knightspan/Nashik-Water/docs/screenshots/admin-ingest.png

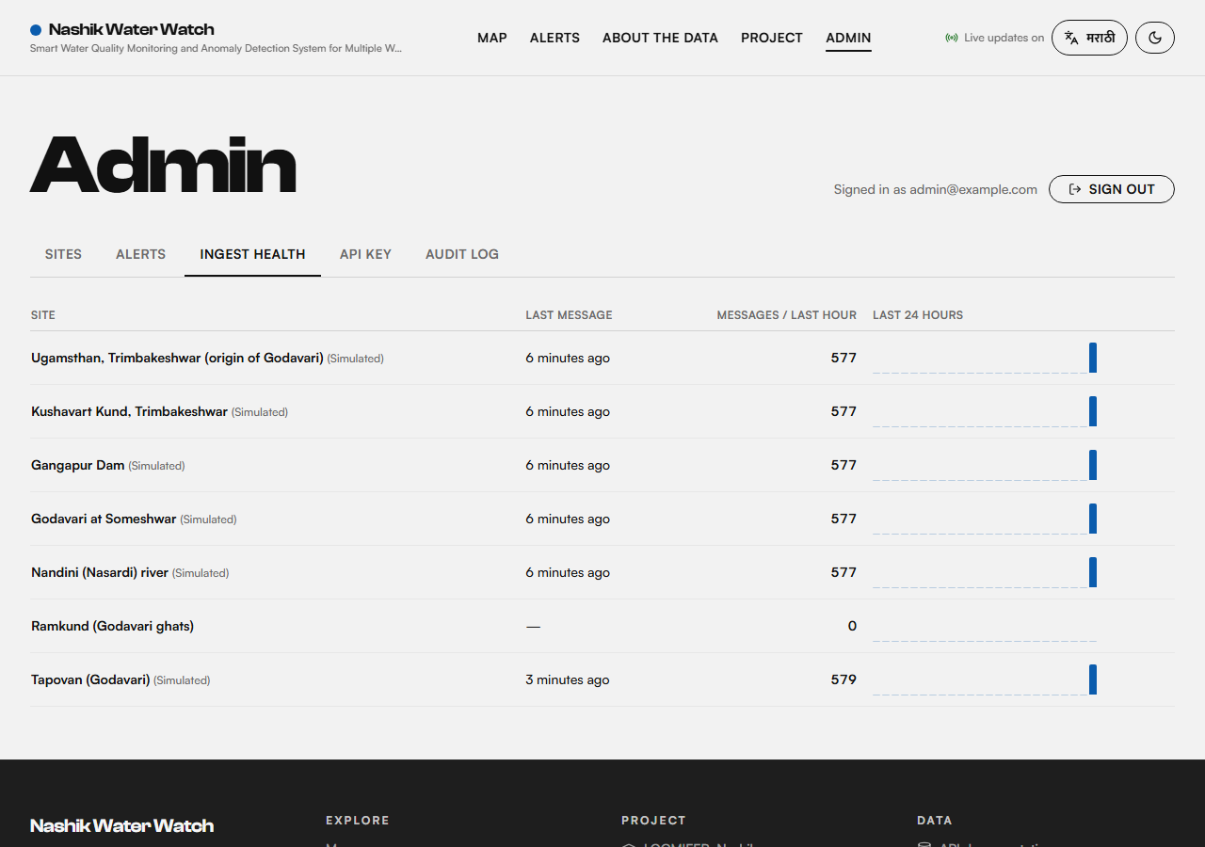
docs/screenshots/admin-ingest.png
