knightspan/Nashik-Water/docs/screenshots/site-phone-mr.png

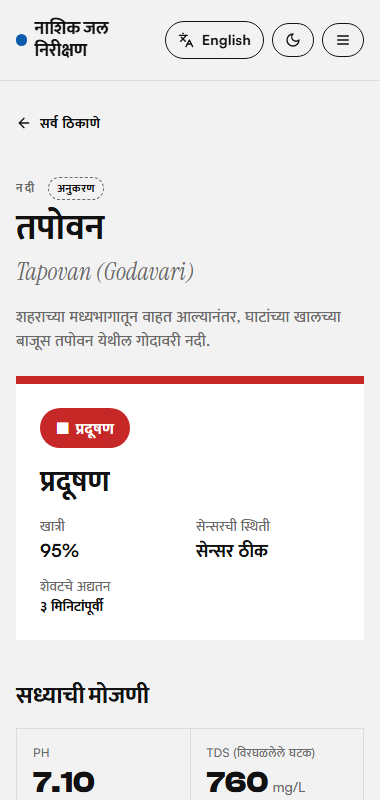
docs/screenshots/site-phone-mr.png
