knightspan/Nashik-Water/WQM_code/diagrams/a4_boxplot.png

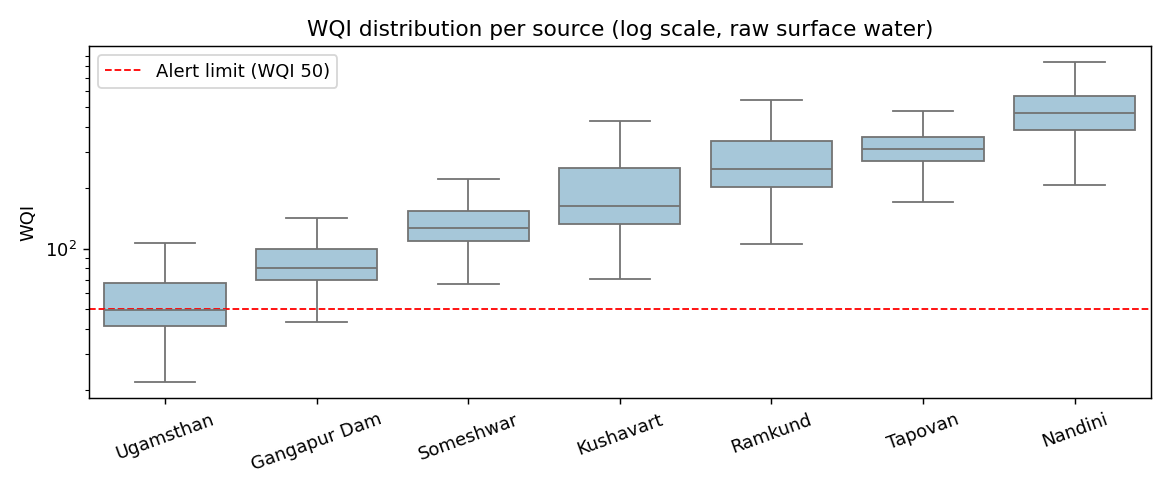
WQM_code/diagrams/a4_boxplot.png
