knightspan/Nashik-Water/WQM_code/diagrams/a4_corr.png

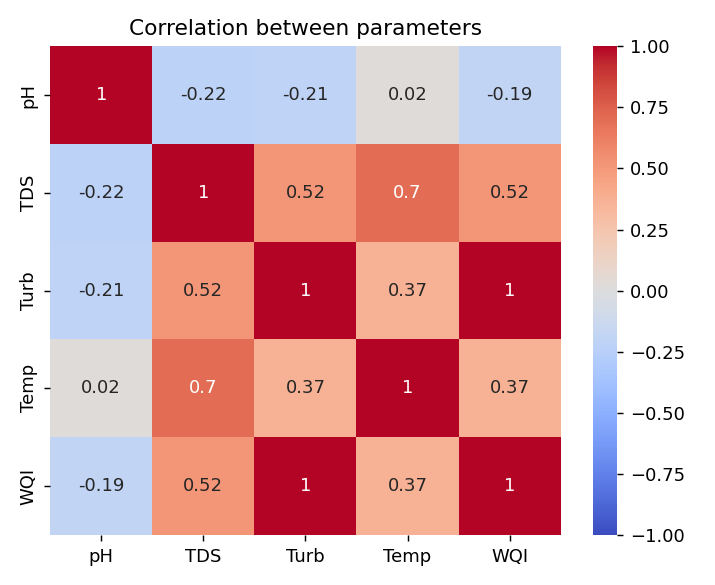
WQM_code/diagrams/a4_corr.png
