knightspan/Nashik-Water/WQM_code/diagrams/a4_diurnal.png

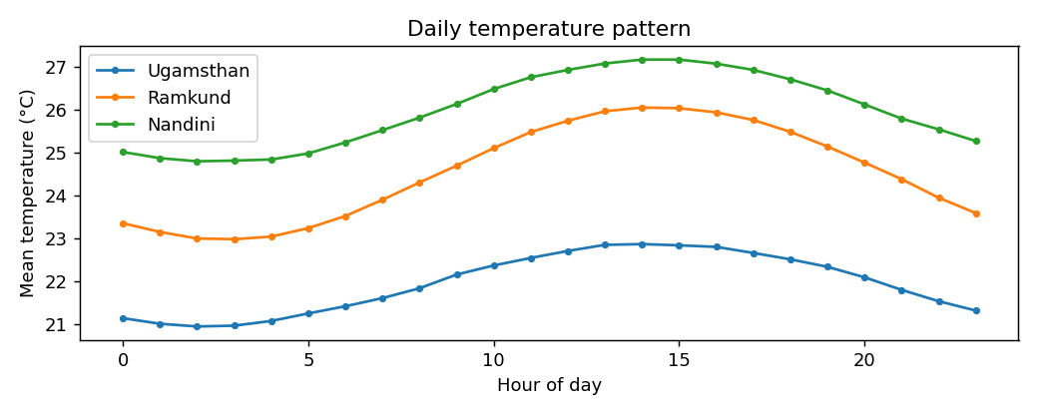
WQM_code/diagrams/a4_diurnal.png
