knightspan/Nashik-Water/WQM_code/diagrams/a4_hampel.png

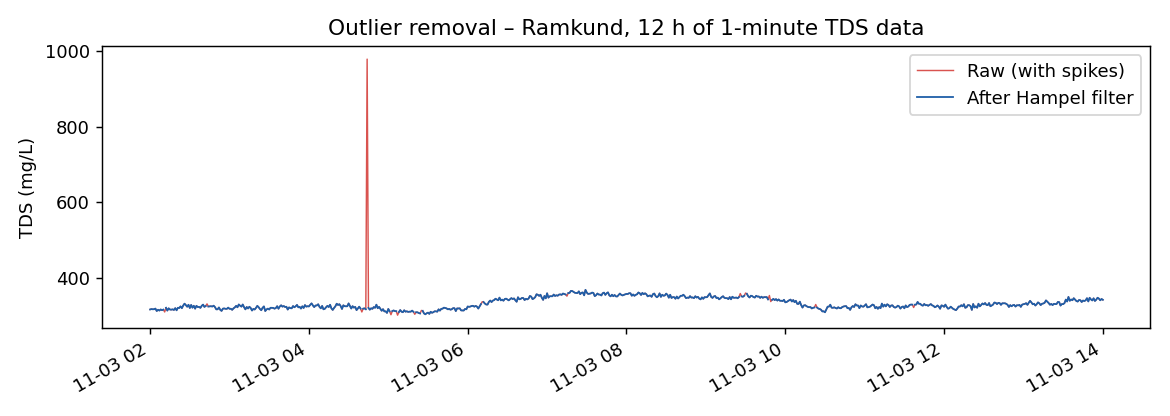
WQM_code/diagrams/a4_hampel.png
