knightspan/Nashik-Water/WQM_code/diagrams/a4_means.png

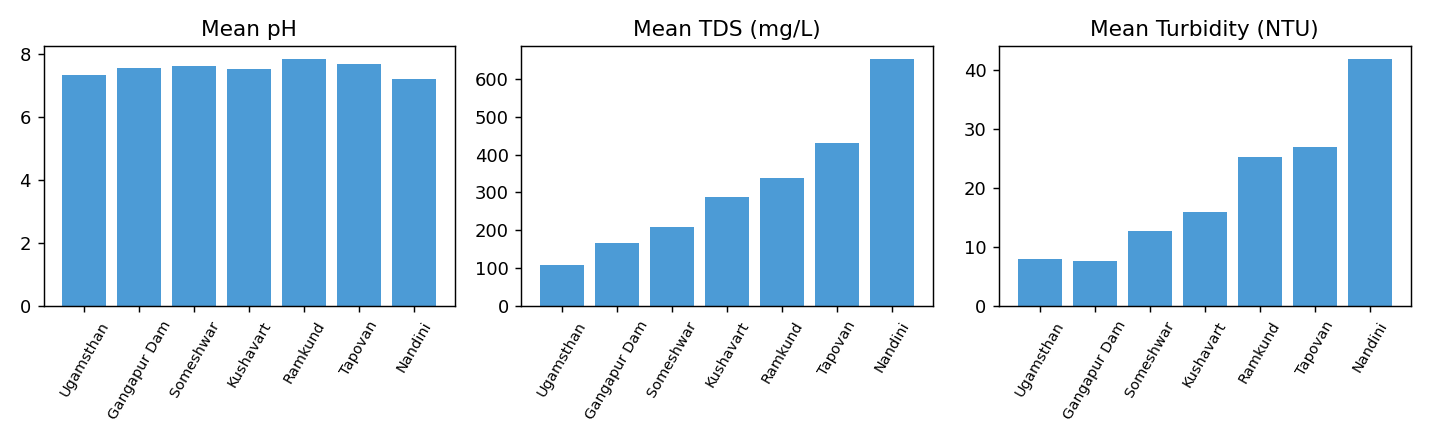
WQM_code/diagrams/a4_means.png
