knightspan/Nashik-Water/WQM_code/diagrams/a4_missing.png

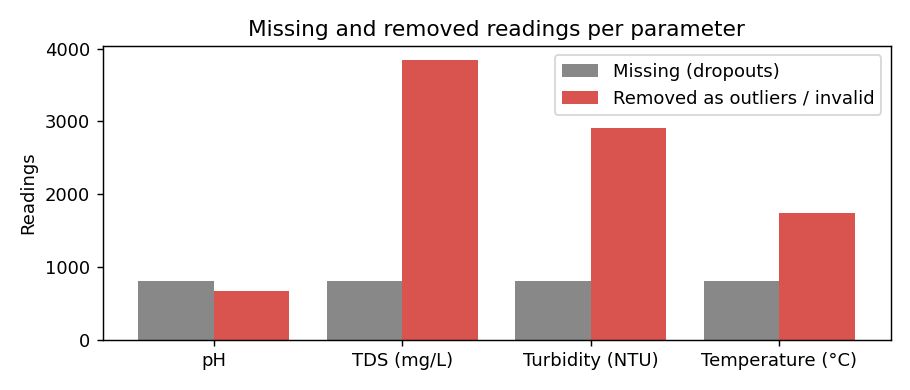
WQM_code/diagrams/a4_missing.png
