knightspan/Nashik-Water/WQM_code/diagrams/a4_timeseries.png

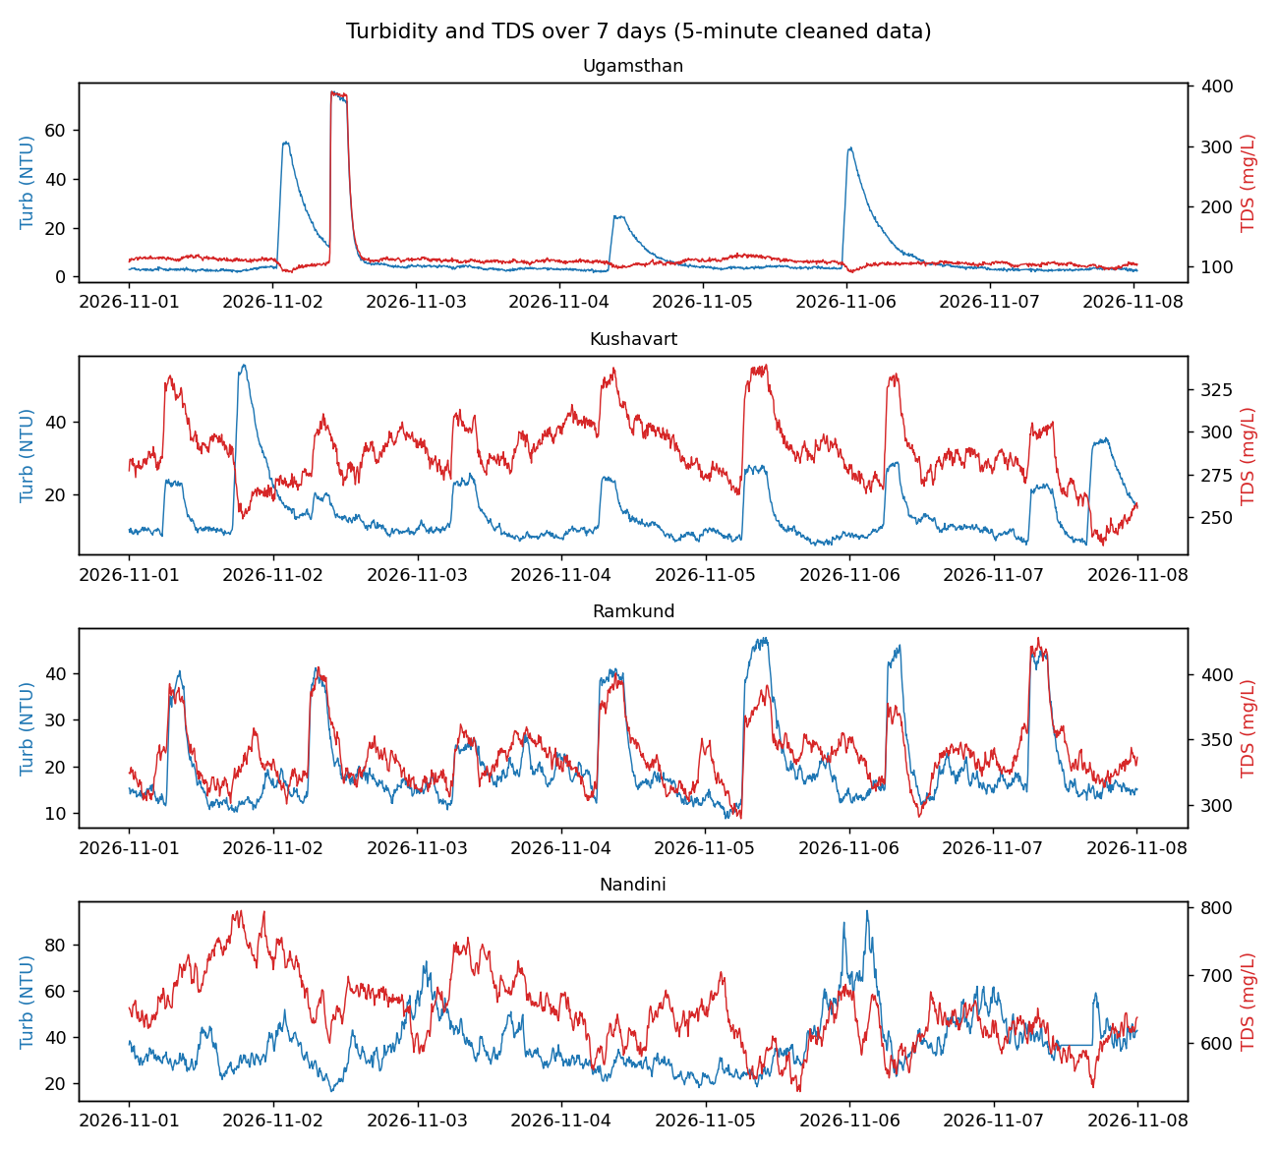
WQM_code/diagrams/a4_timeseries.png
