knightspan/Nashik-Water/WQM_code/diagrams/a5_classes.png

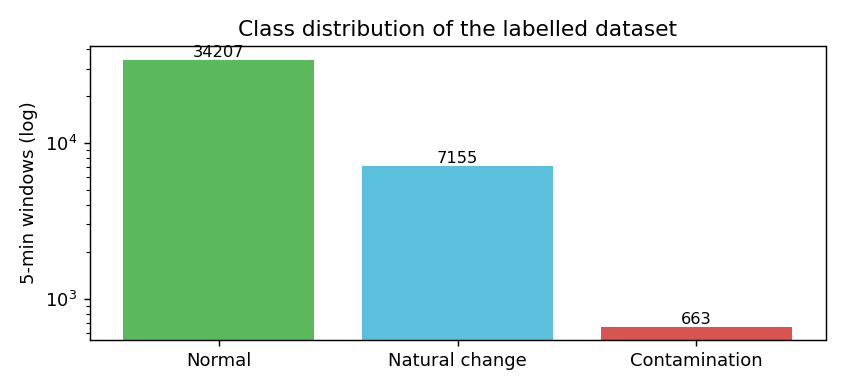
WQM_code/diagrams/a5_classes.png
