knightspan/Nashik-Water/WQM_code/diagrams/a5_cm_decision_tree.png

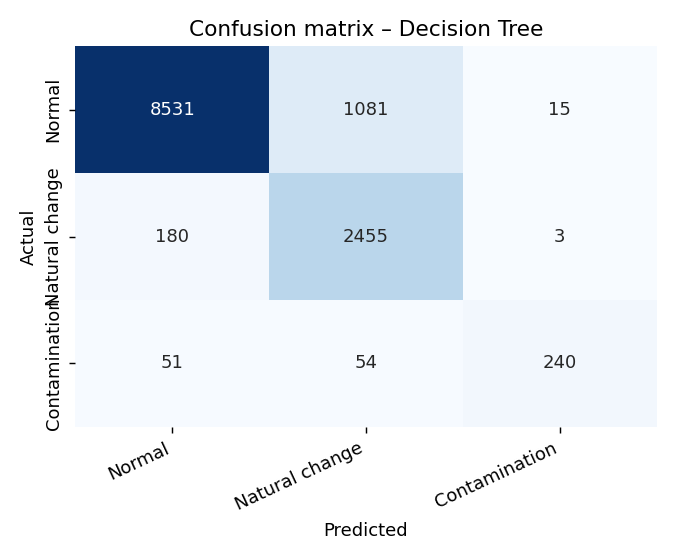
WQM_code/diagrams/a5_cm_decision_tree.png
