knightspan/Nashik-Water/WQM_code/diagrams/a5_comparison.png

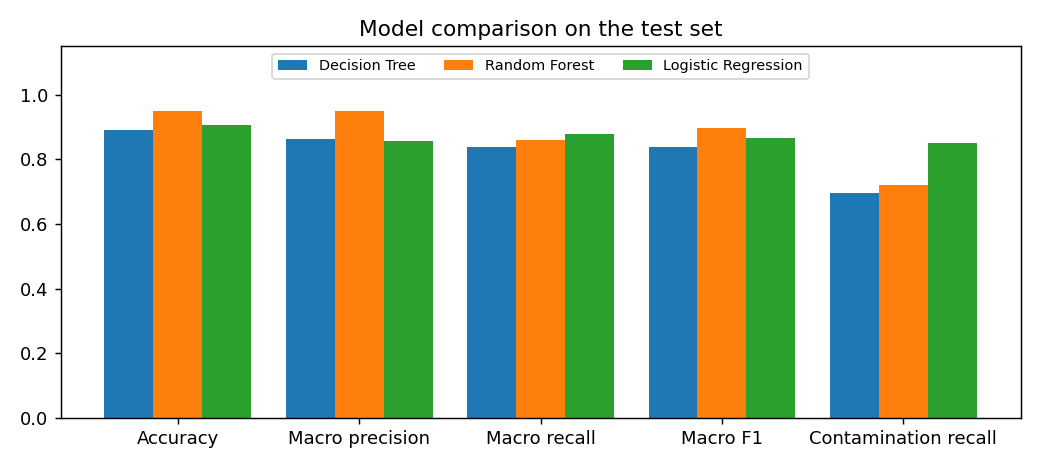
WQM_code/diagrams/a5_comparison.png
