knightspan/Nashik-Water/WQM_code/diagrams/a5_importance.png

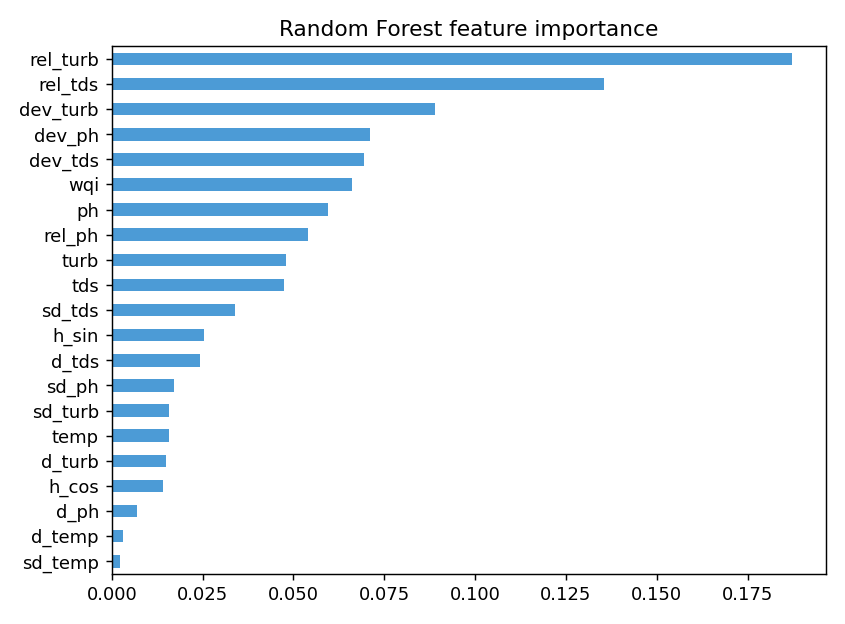
WQM_code/diagrams/a5_importance.png
