knightspan/Nashik-Water/WQM_code/diagrams/a6_confidence.png

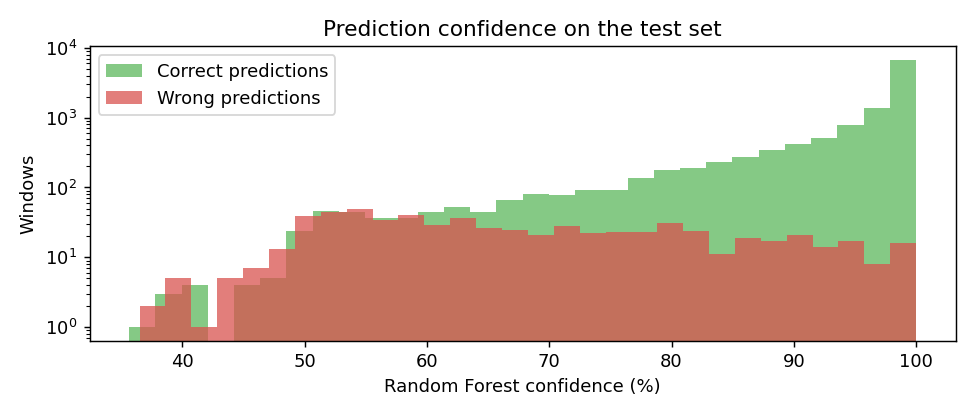
WQM_code/diagrams/a6_confidence.png
