knightspan/Nashik-Water/WQM_code/diagrams/a6_event.png

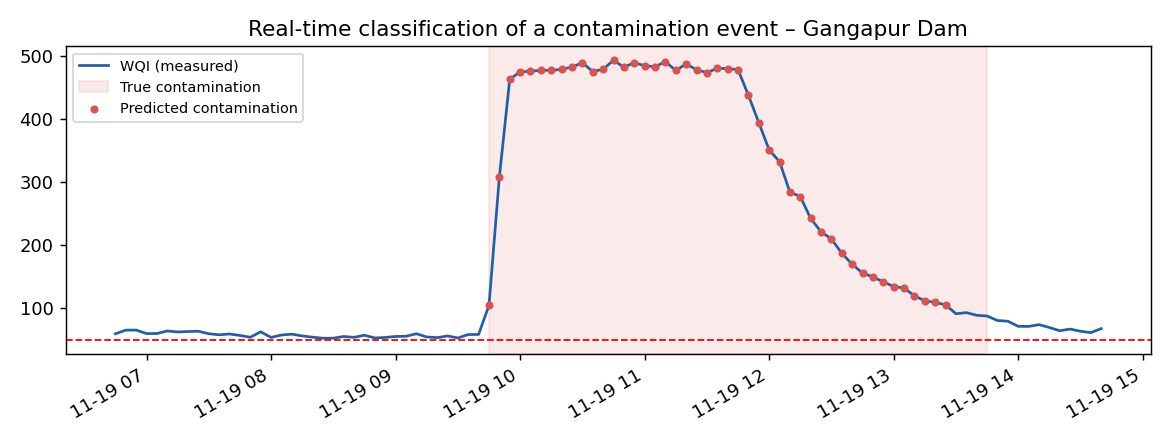
WQM_code/diagrams/a6_event.png
