knightspan/Nashik-Water/WQM_code/diagrams/a6_health_cm.png

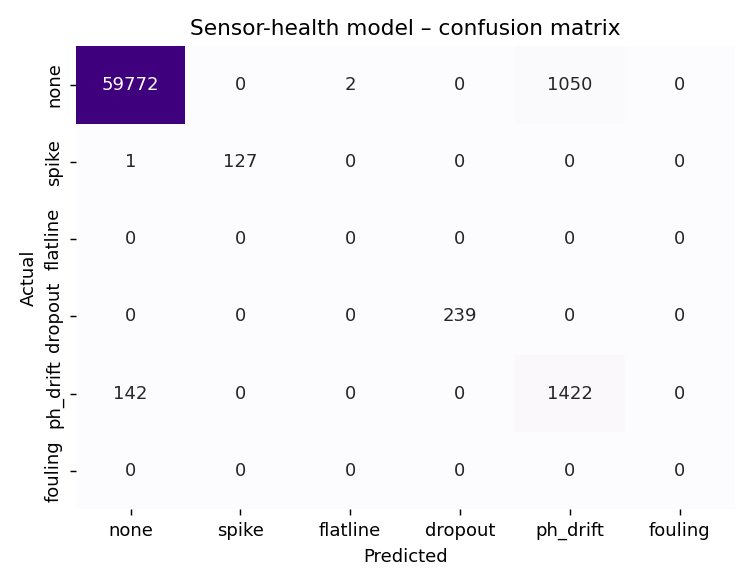
WQM_code/diagrams/a6_health_cm.png
