knightspan/Nashik-Water/WQM_code/diagrams/a7_edge_cm.png

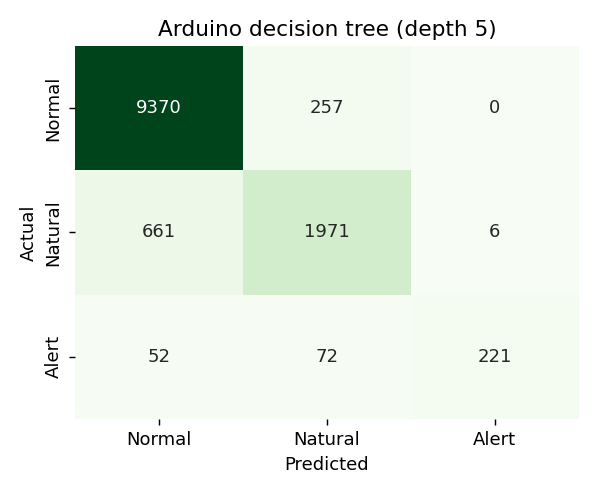
WQM_code/diagrams/a7_edge_cm.png
