knightspan/Nashik-Water/WQM_code/diagrams/alert_flow.png

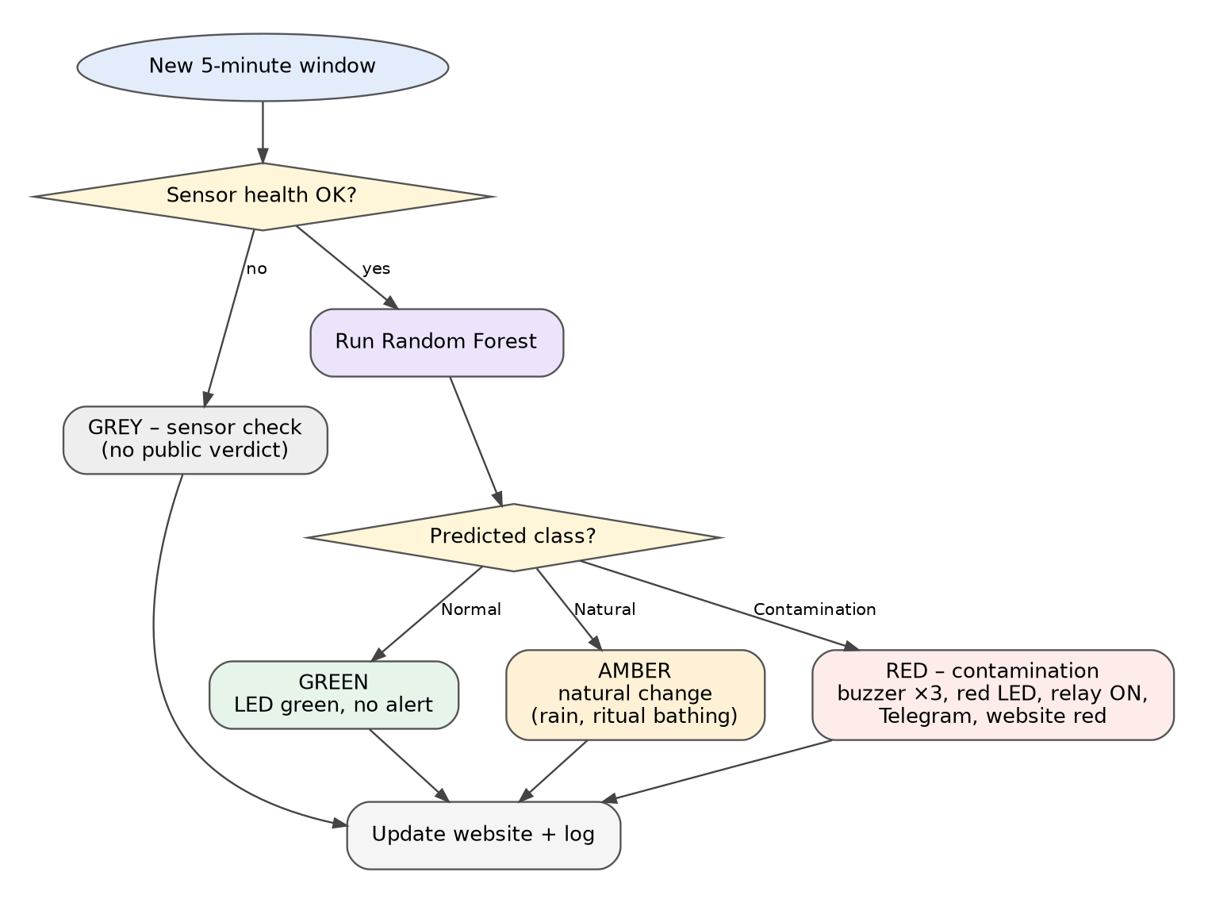
WQM_code/diagrams/alert_flow.png
