knightspan/Nashik-Water/WQM_code/diagrams/arduino_flow.png

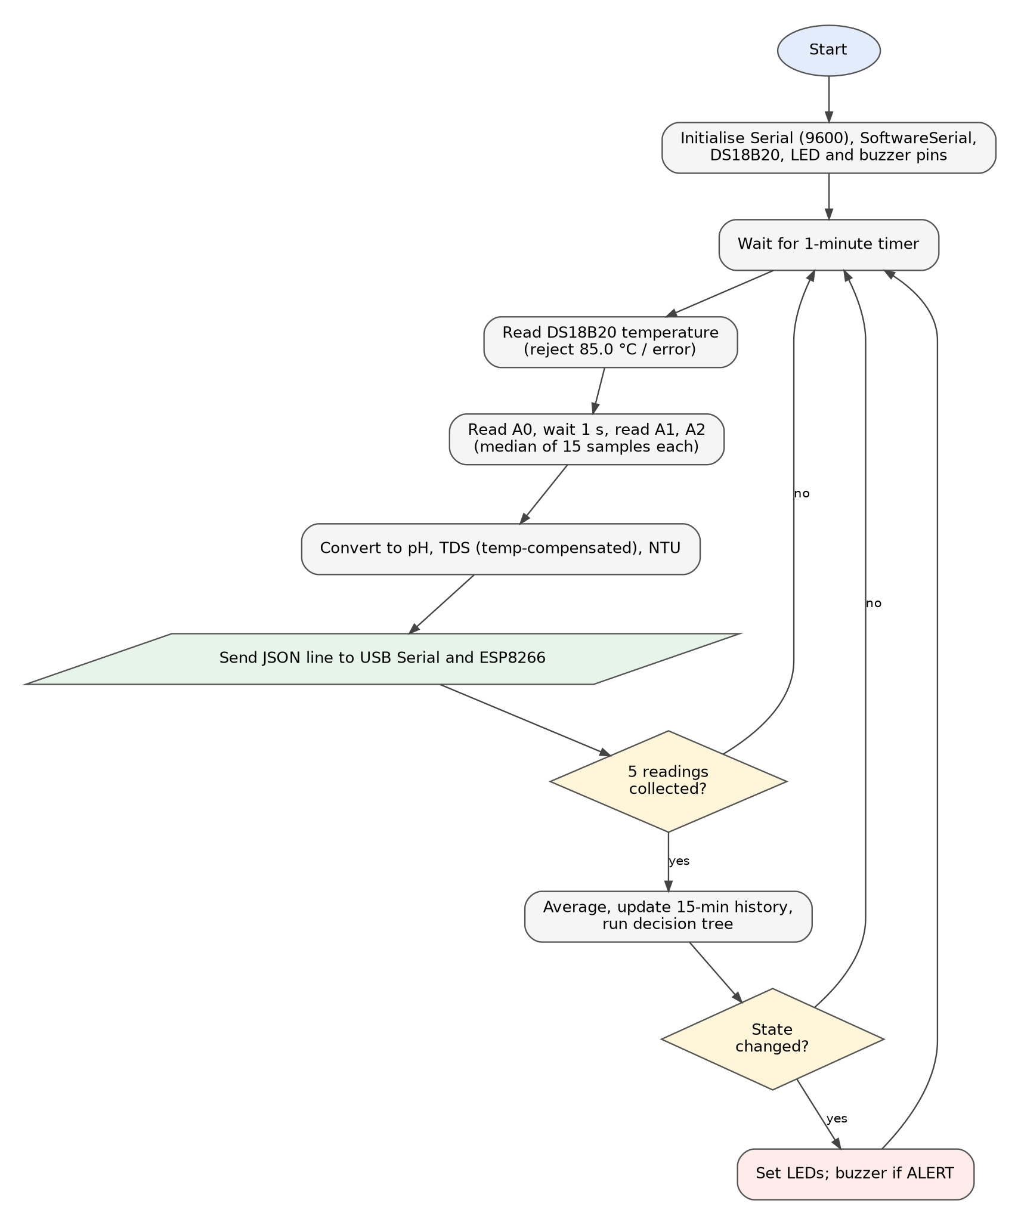
WQM_code/diagrams/arduino_flow.png
