knightspan/Nashik-Water/WQM_code/diagrams/cloud_flow.png

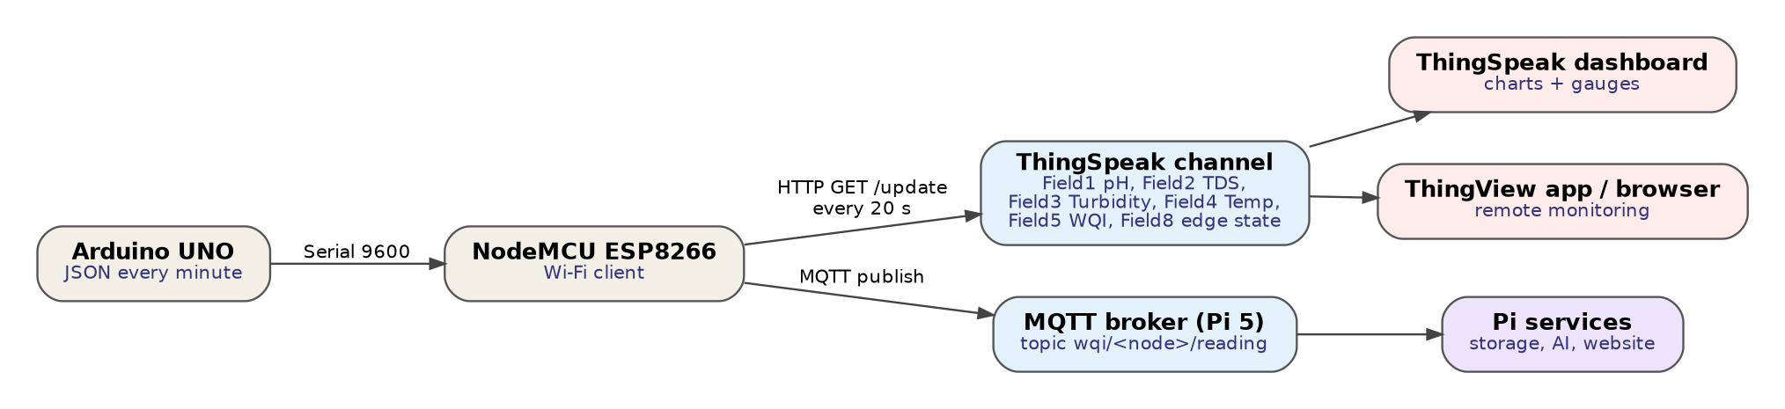
WQM_code/diagrams/cloud_flow.png
