knightspan/Nashik-Water/WQM_code/diagrams/design_thinking.png

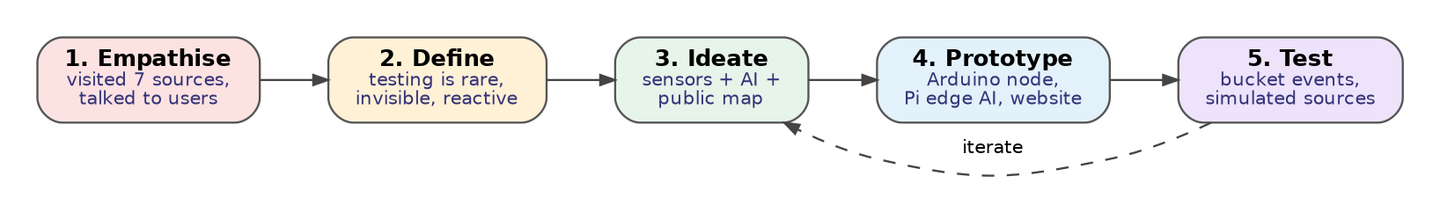
WQM_code/diagrams/design_thinking.png
