knightspan/Nashik-Water/WQM_code/diagrams/edge_cloud.png

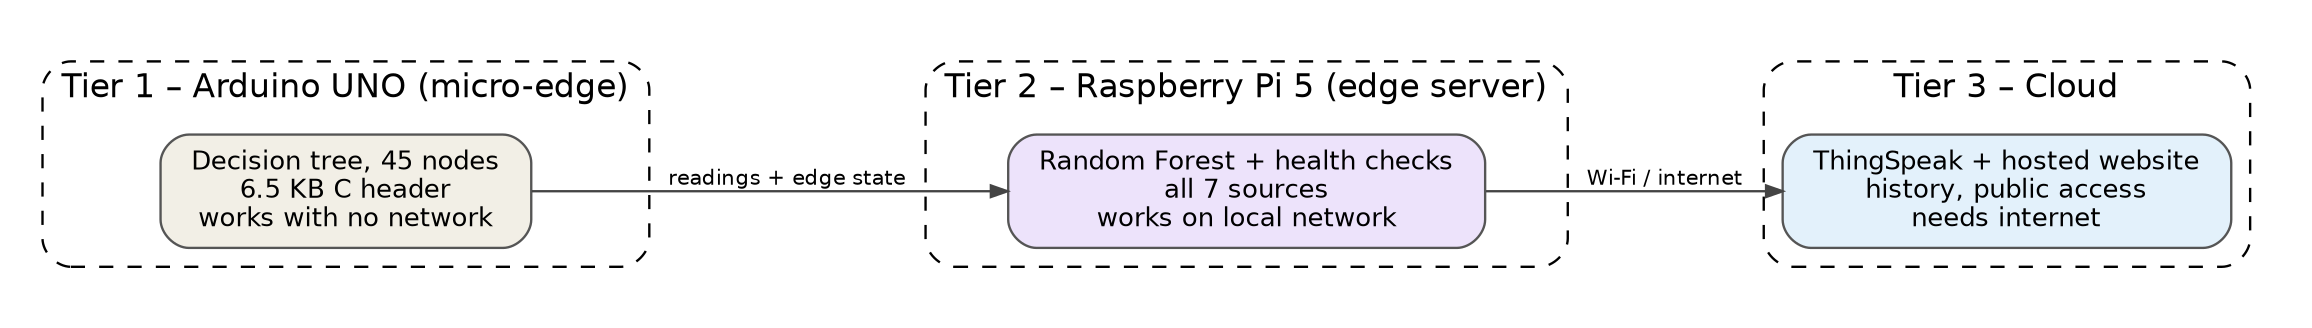
WQM_code/diagrams/edge_cloud.png
