knightspan/Nashik-Water/WQM_code/diagrams/esp_flow.png

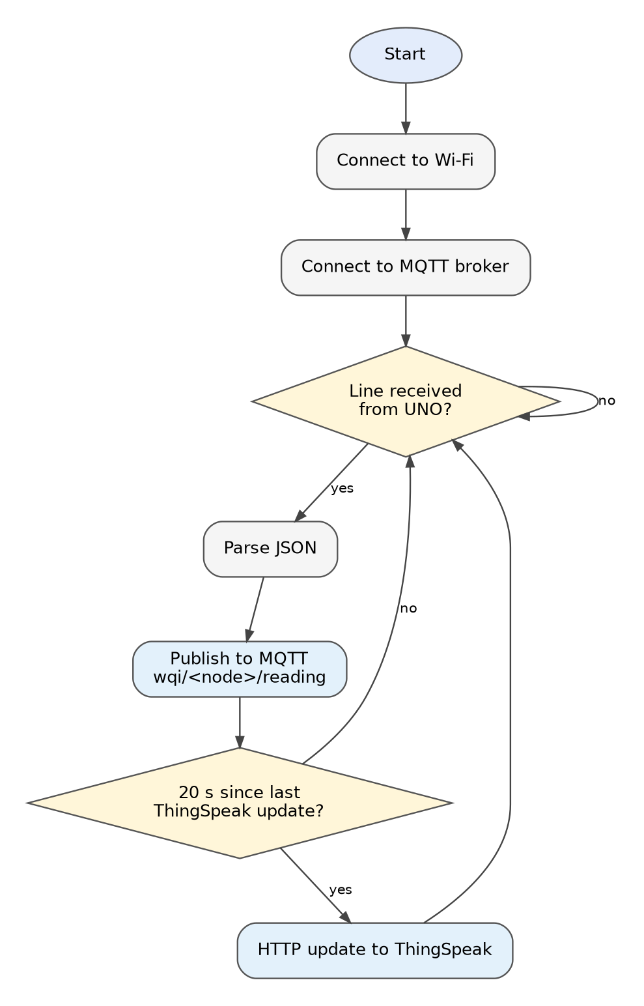
WQM_code/diagrams/esp_flow.png
