knightspan/Nashik-Water/WQM_code/diagrams/gantt.png

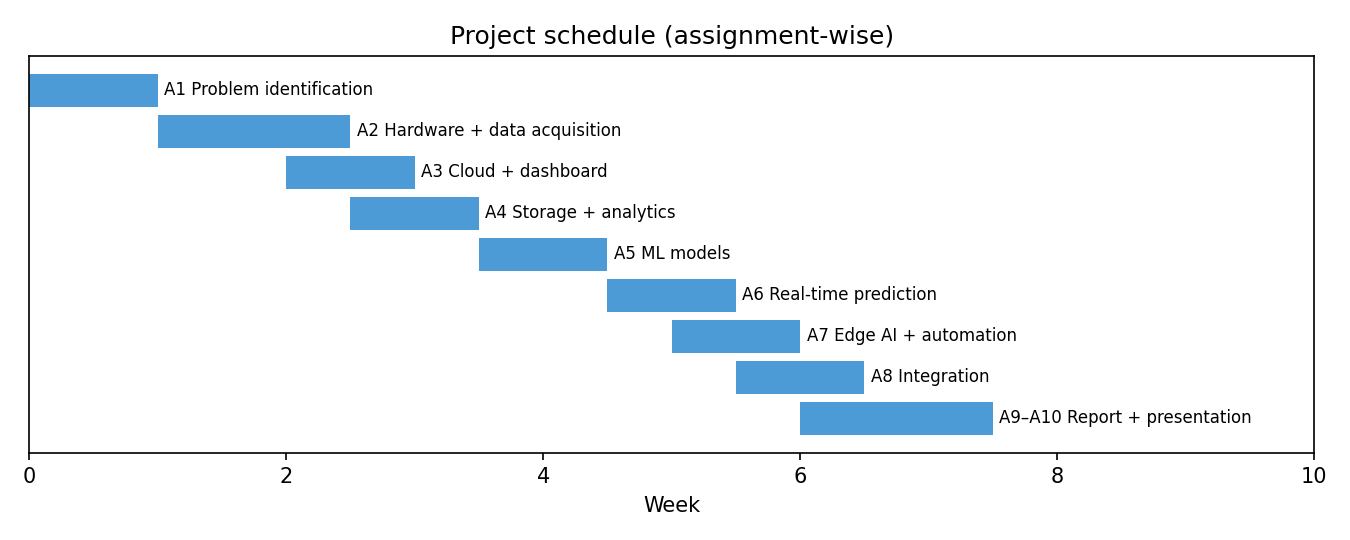
WQM_code/diagrams/gantt.png
