knightspan/Nashik-Water/WQM_code/diagrams/hw_block.png

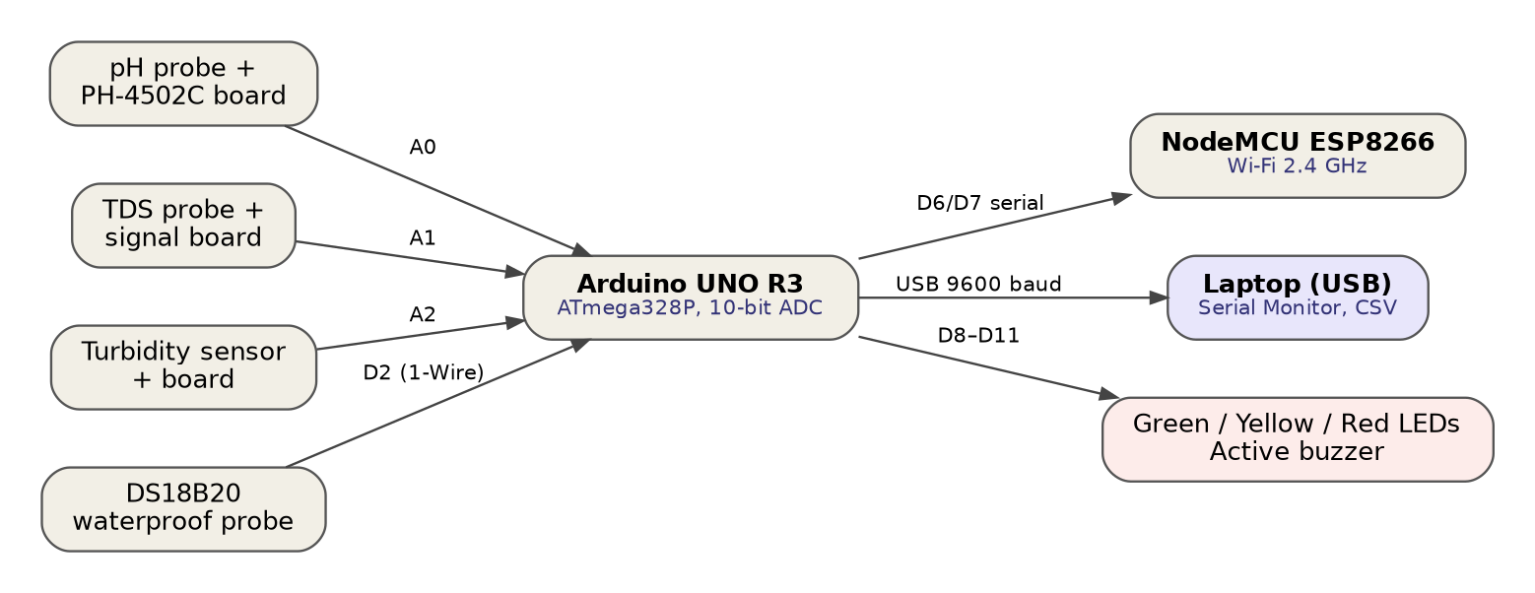
WQM_code/diagrams/hw_block.png
