knightspan/Nashik-Water/WQM_code/diagrams/integrated.png

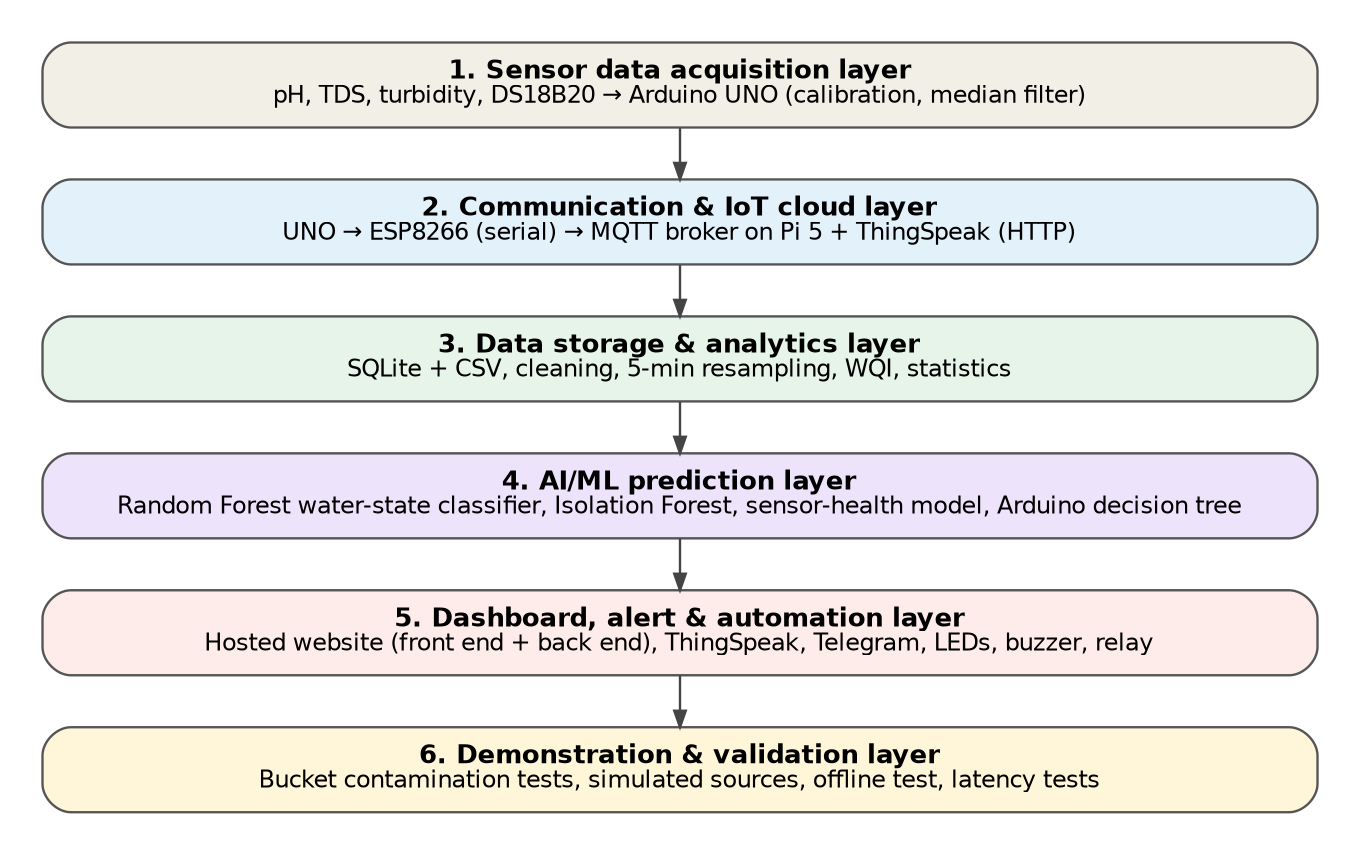
WQM_code/diagrams/integrated.png
