knightspan/Nashik-Water/WQM_code/diagrams/ml_workflow.png

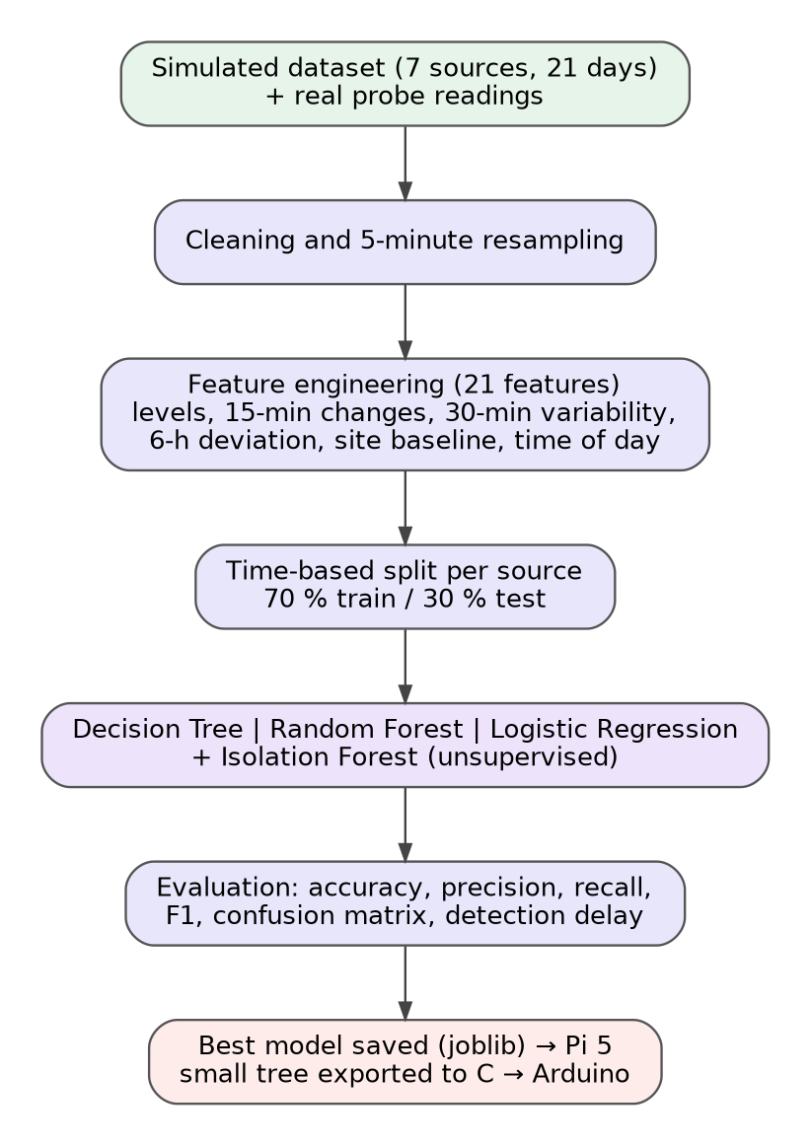
WQM_code/diagrams/ml_workflow.png
