knightspan/Nashik-Water/WQM_code/diagrams/pi_program_flow.png

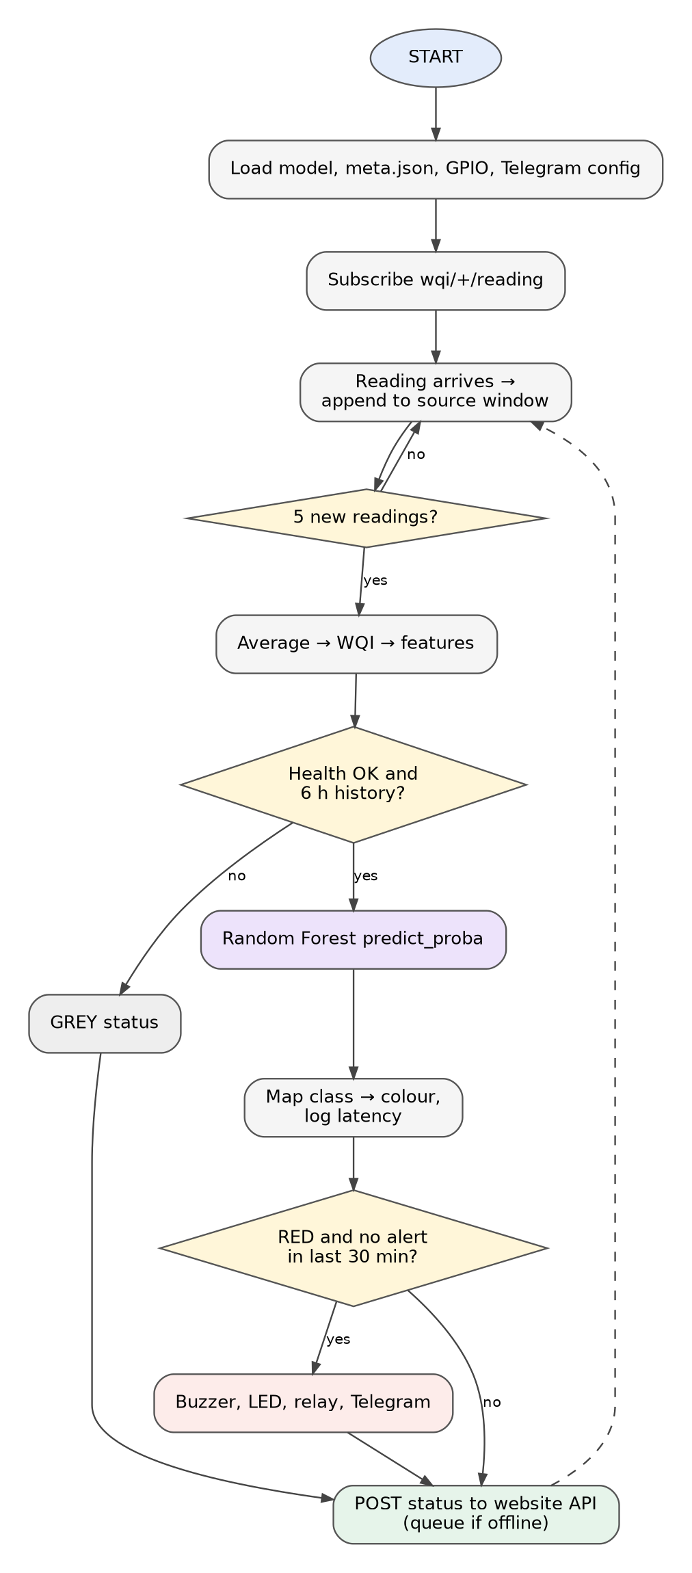
WQM_code/diagrams/pi_program_flow.png
