knightspan/Nashik-Water/WQM_code/diagrams/portal_flow.png

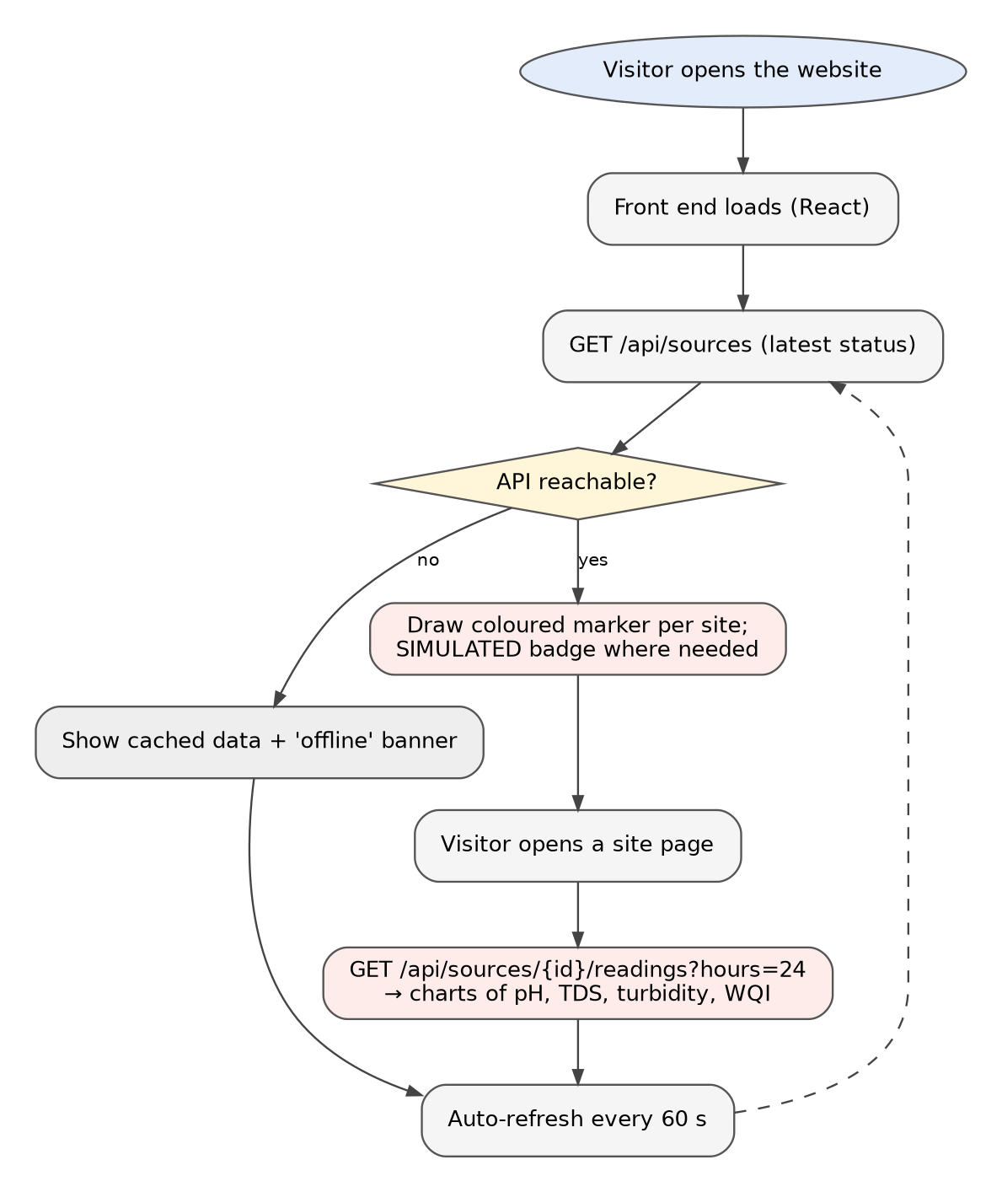
WQM_code/diagrams/portal_flow.png
