knightspan/Nashik-Water/WQM_code/diagrams/rt_arch.png

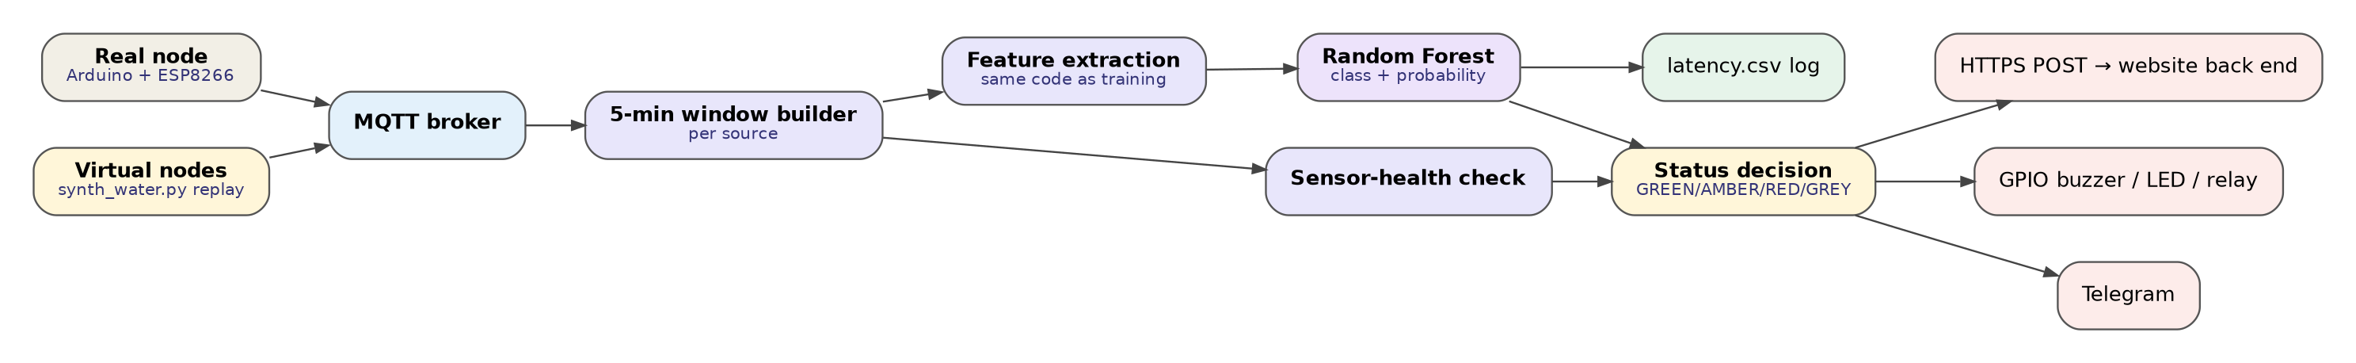
WQM_code/diagrams/rt_arch.png
