knightspan/Nashik-Water/WQM_code/diagrams/stakeholders.png

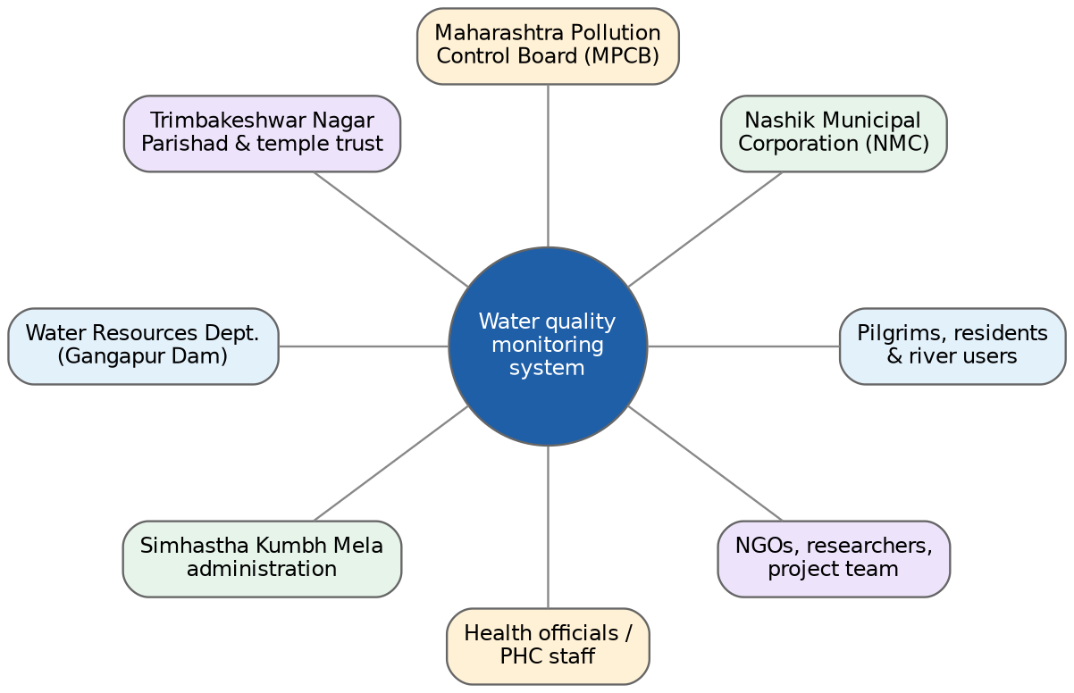
WQM_code/diagrams/stakeholders.png
