knightspan/Nashik-Water/WQM_code/diagrams/syn1_arch.png

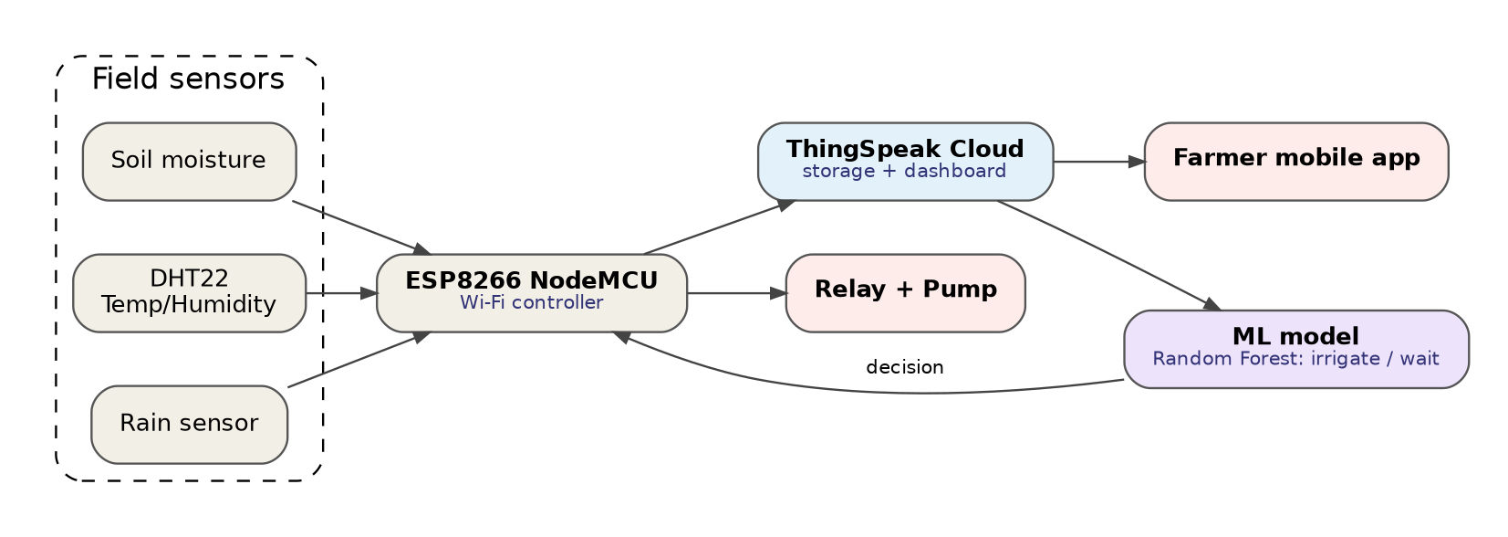
WQM_code/diagrams/syn1_arch.png
