knightspan/Nashik-Water/WQM_code/diagrams/syn1_dfd.png

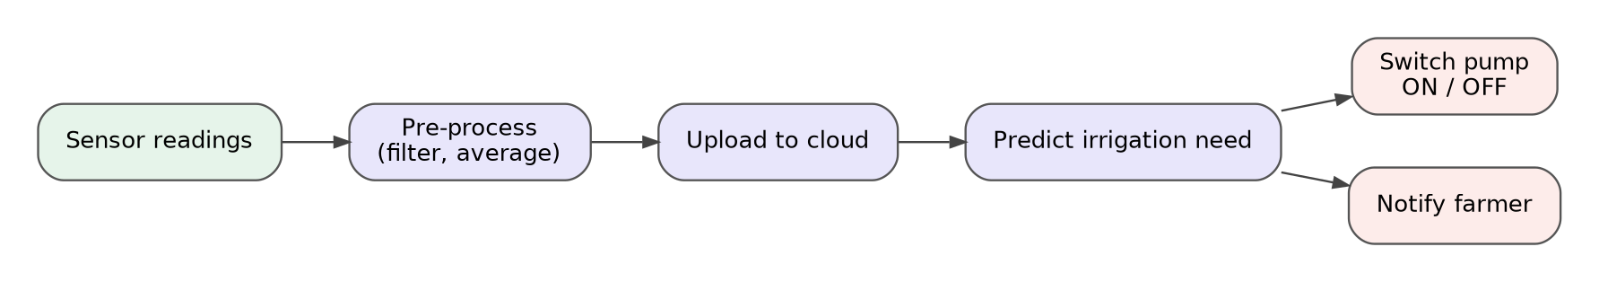
WQM_code/diagrams/syn1_dfd.png
