knightspan/Nashik-Water/WQM_code/diagrams/syn2_arch.png

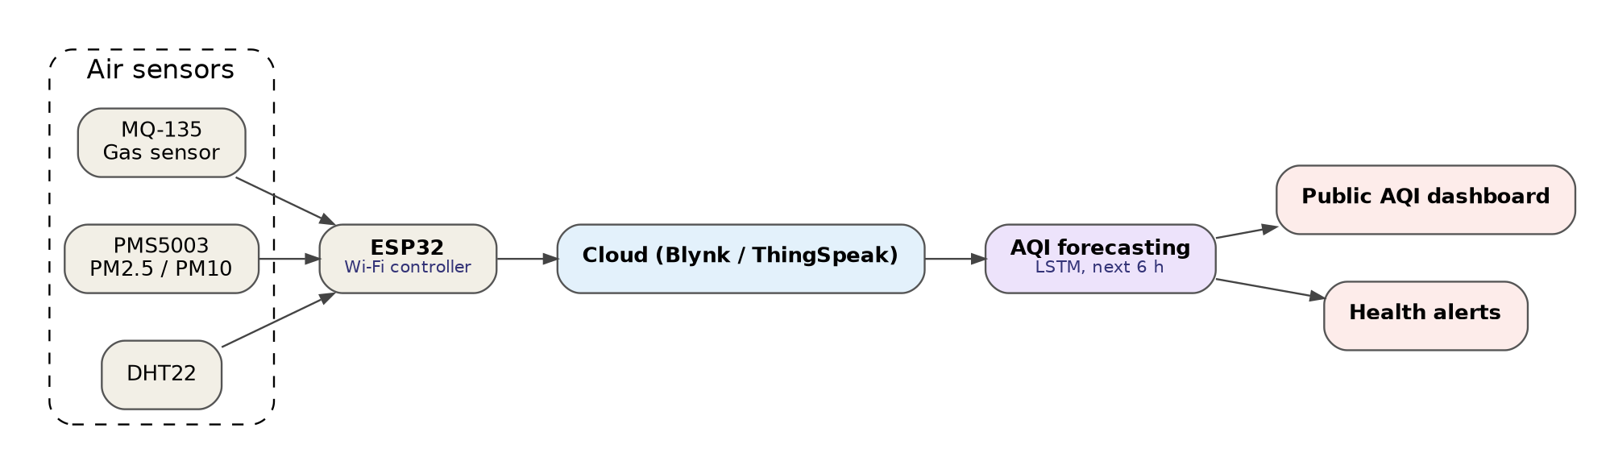
WQM_code/diagrams/syn2_arch.png
