knightspan/Nashik-Water/WQM_code/diagrams/syn3_arch.png

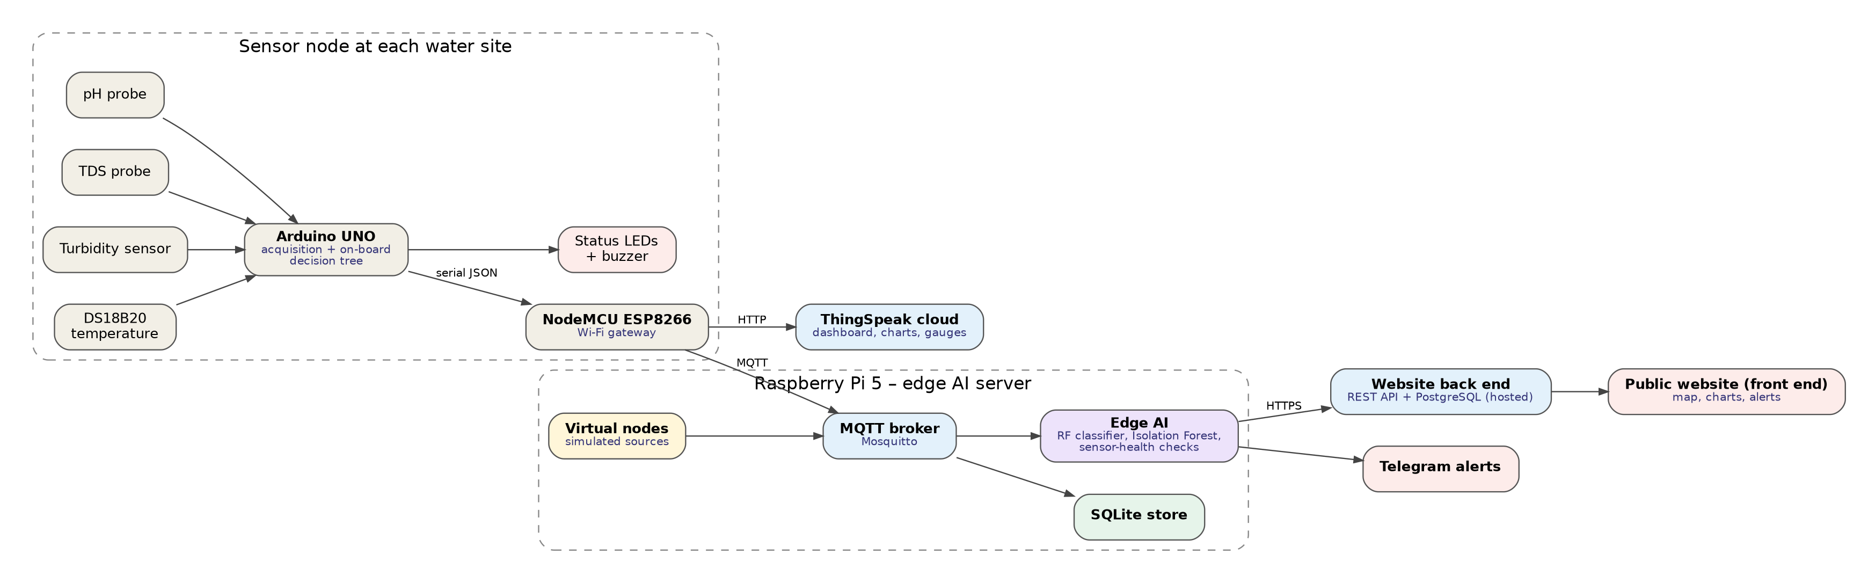
WQM_code/diagrams/syn3_arch.png
