knightspan/Nashik-Water/WQM_code/diagrams/syn3_dfd.png

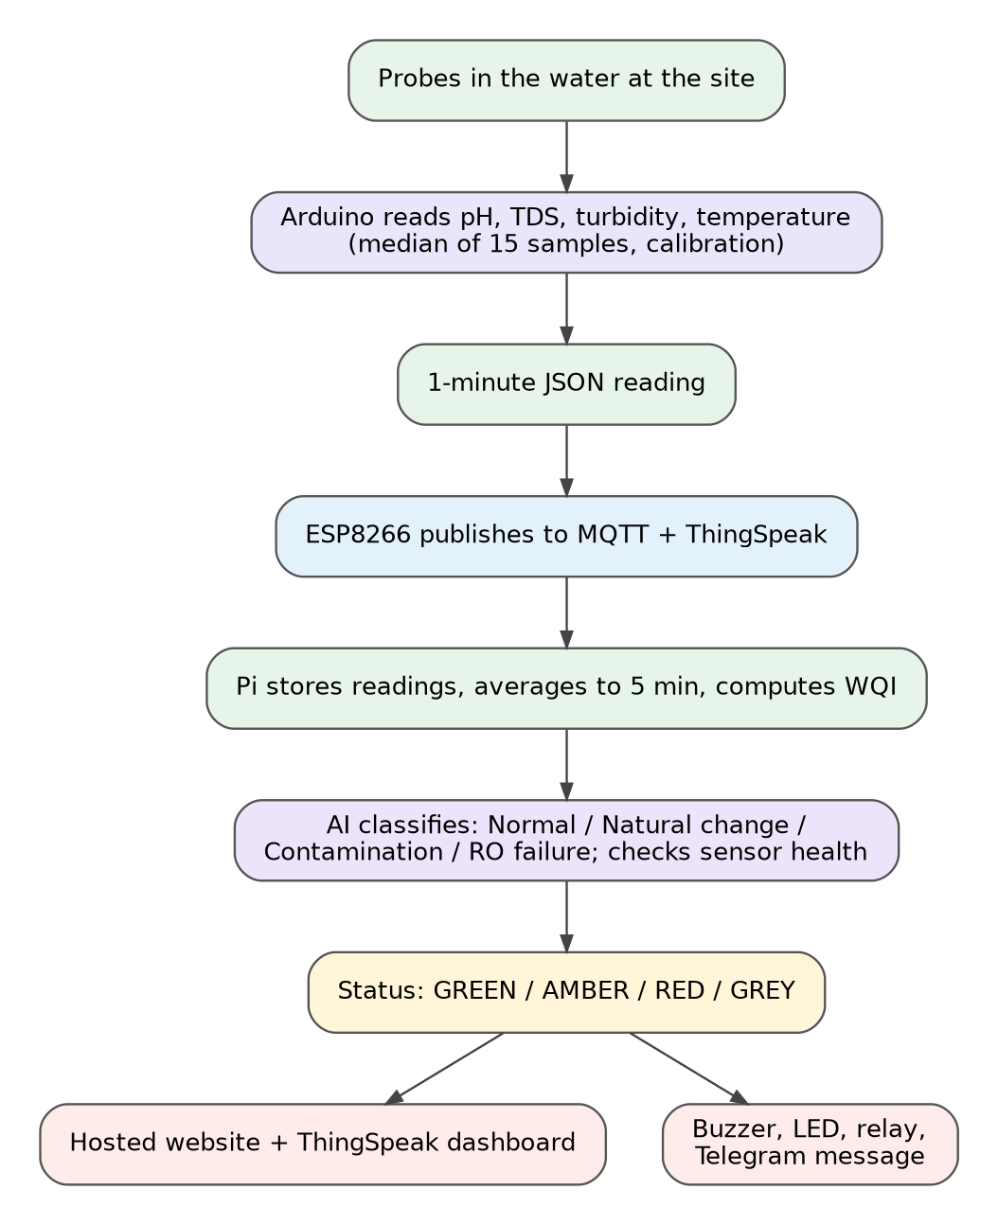
WQM_code/diagrams/syn3_dfd.png
