knightspan/Nashik-Water/WQM_code/diagrams/system_arch.png

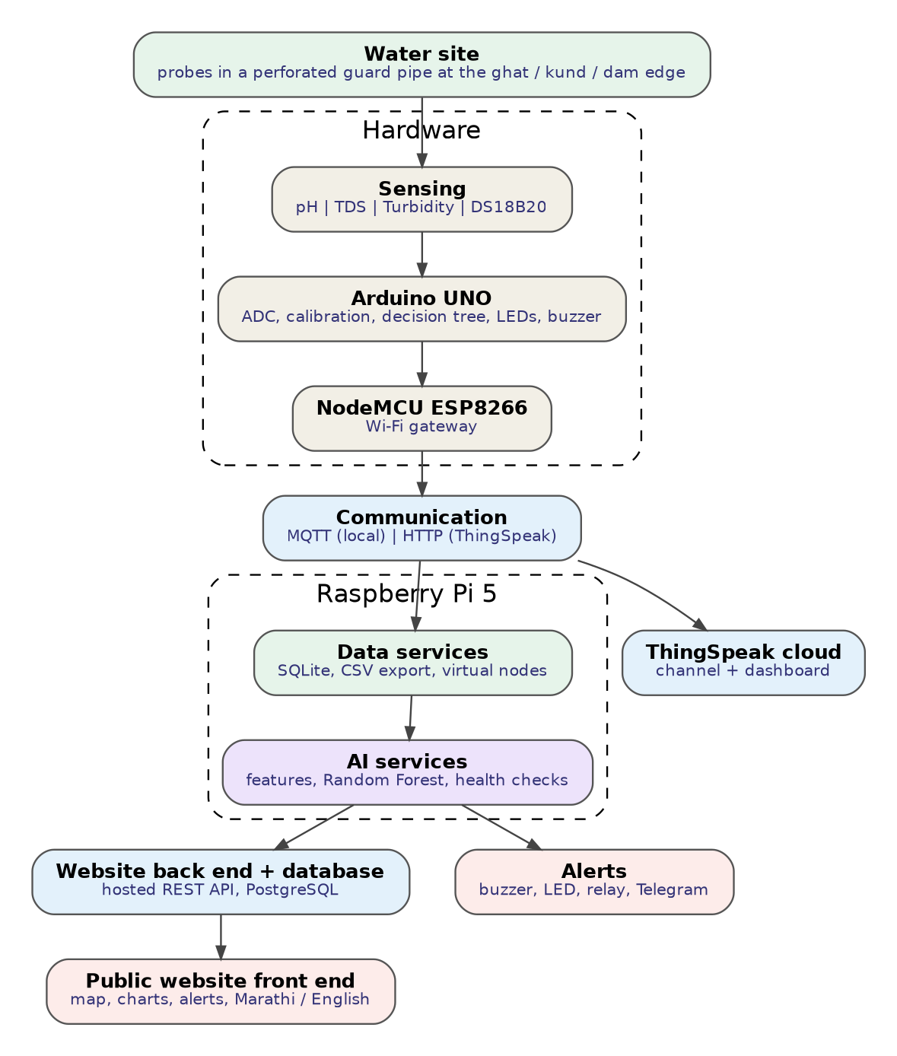
WQM_code/diagrams/system_arch.png
