knightspan/Nashik-Water/WQM_code/diagrams/web_arch.png

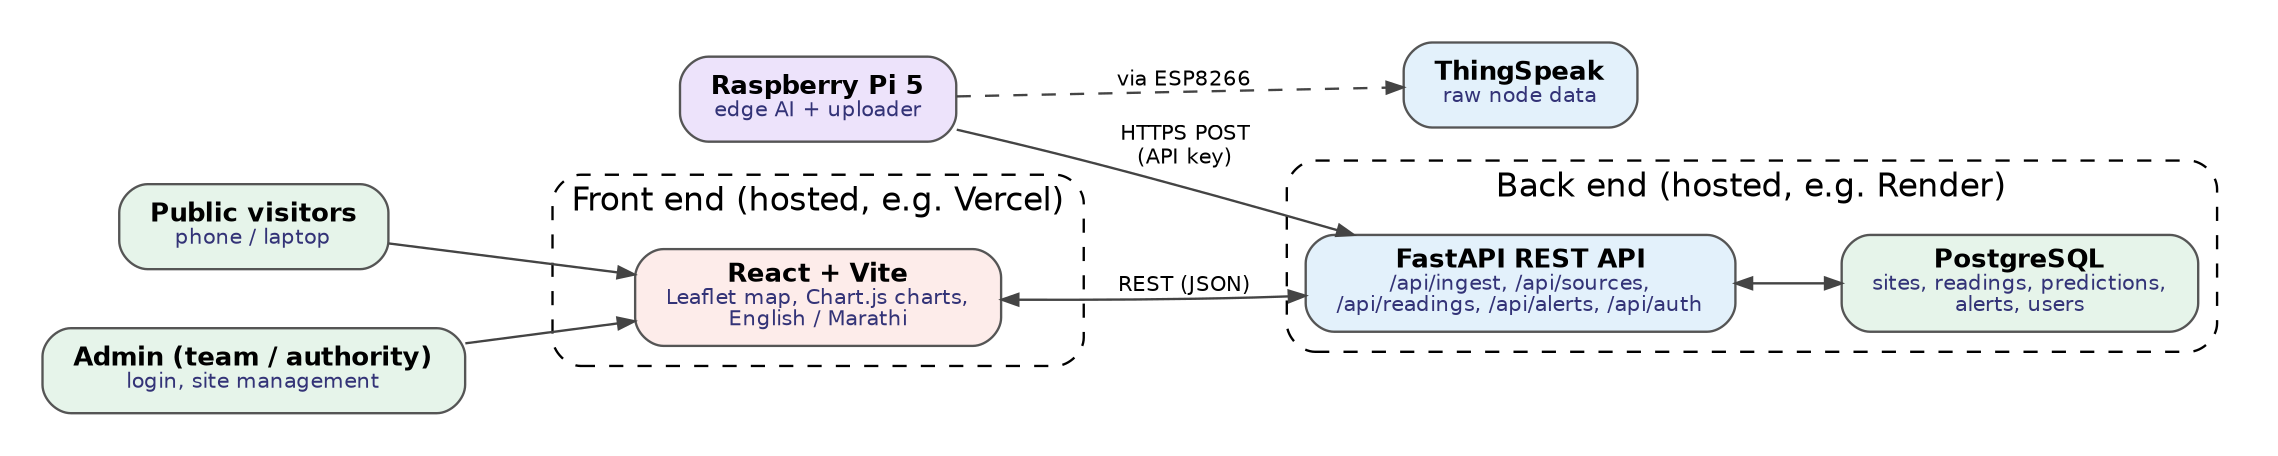
WQM_code/diagrams/web_arch.png
