knightspan/Nashik-Water/WQM_code/diagrams/working_flow.png

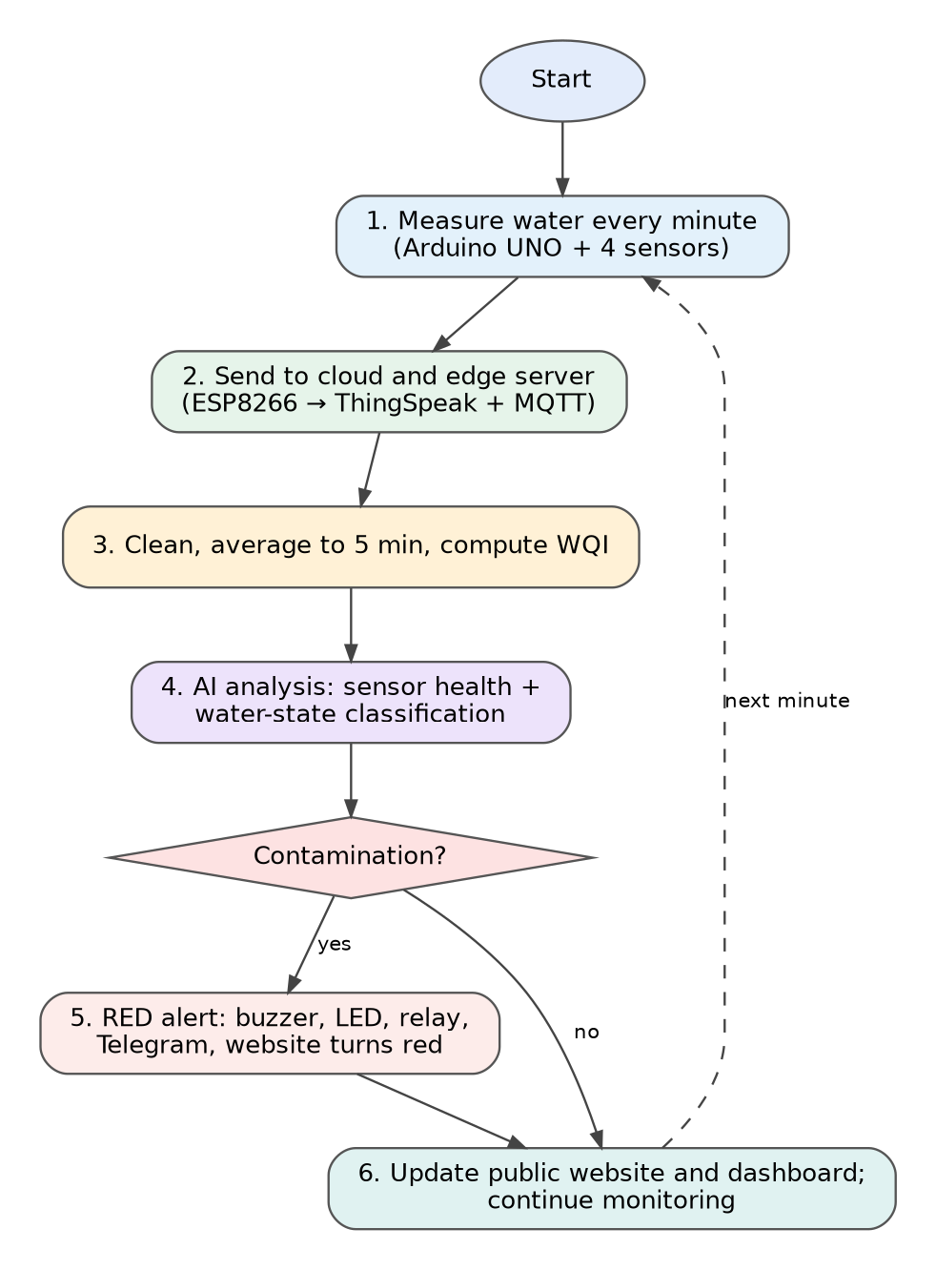
WQM_code/diagrams/working_flow.png
