knightspan/Nashik-Water/WQM_code/diagrams/wiring.png

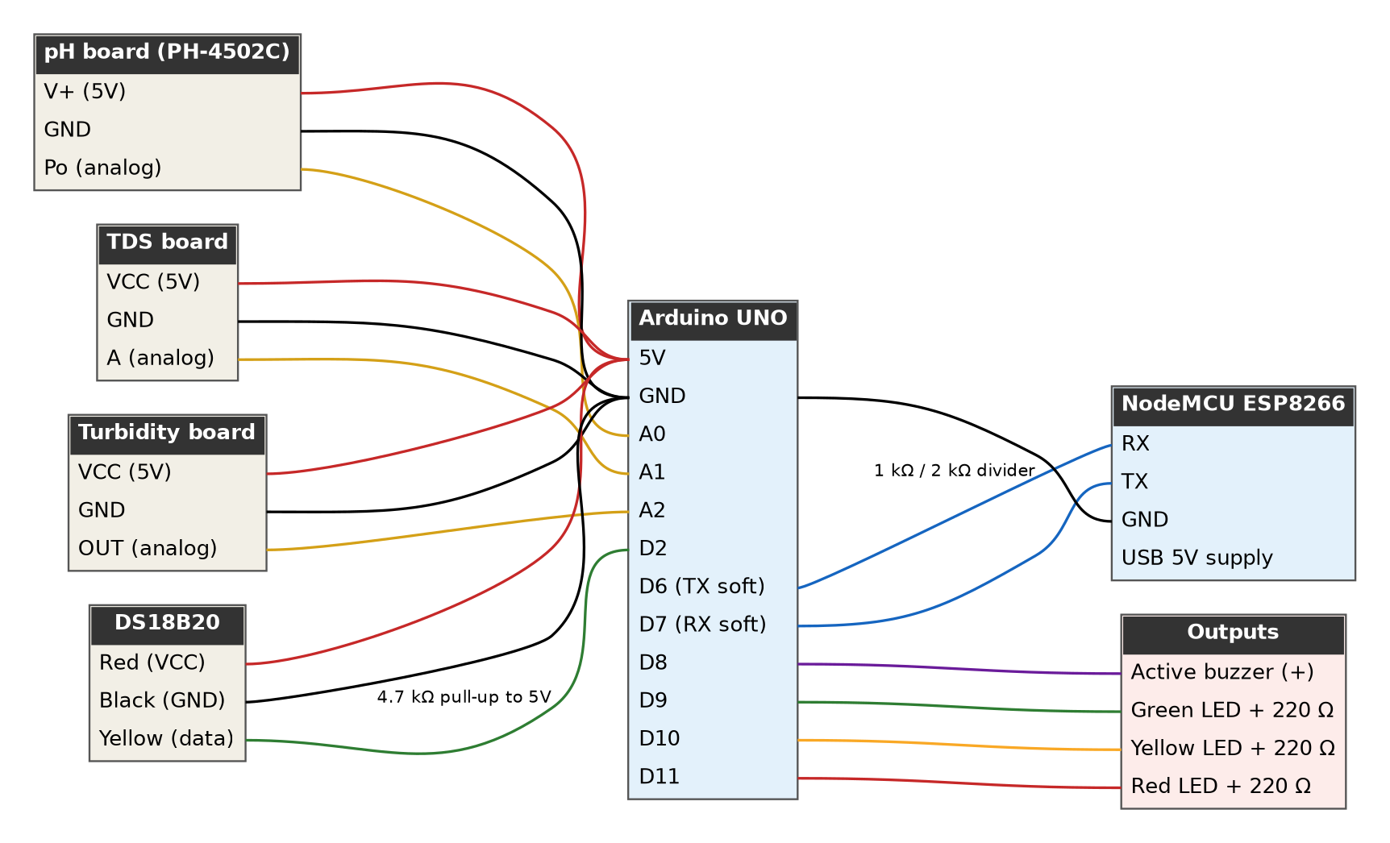
WQM_code/diagrams/wiring.png
