knightspan/Nashik-Water/WQM_code/arduino_node/WaterStateTree.h

#pragma once
#include <stdarg.h>
namespace Eloquent {
    namespace ML {
        namespace Port {
            class WaterStateTree {
                public:
                    /**
                    * Predict class for features vector
                    */
                    int predict(float *x) {
                        if (x[2] <= 1.6939718127250671) {
                            if (x[2] <= 1.354601502418518) {
                                if (x[2] <= 1.222217321395874) {
                                    if (x[0] <= 0.6639000177383423) {
                                        if (x[0] <= -0.14400000125169754) {
                                            return 0;
                                        }

                                        else {
                                            return 0;
                                        }
                                    }

                                    else {
                                        if (x[1] <= 0.9626210629940033) {
                                            return 1;
                                        }

                                        else {
                                            return 0;
                                        }
                                    }
                                }

                                else {
                                    if (x[1] <= 0.8748985528945923) {
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
                                            return 2;
                                        }

                                        else {
                                            return 1;
                                        }
                                    }

                                    else {
                                        if (x[3] <= 36.52000045776367) {
                                            return 1;
                                        }

                                        else {
                                            return 2;
                                        }
                                    }
                                }
                            }

                            else {
                                if (x[1] <= 1.2967906594276428) {
                                    if (x[3] <= 1.809999942779541) {
                                        return 2;
                                    }

                                    else {
                                        return 1;
                                    }
                                }

                                else {
                                    return 2;
                                }
                            }
                        }
                    }

                    /**
                    * Predict readable class name
                    */
                    const char* predictLabel(float *x) {
                        return idxToLabel(predict(x));
                    }

                    /**
                    * Convert class idx to readable name
                    */
                    const char* idxToLabel(uint8_t classIdx) {
                        switch (classIdx) {
                            case 0:
                            return "NORMAL";
                            case 1:
                            return "NATURAL";
                            case 2:
                            return "ALERT";
                            default:
                            return "Houston we have a problem";
                        }
                    }

                protected:
                };
            }
        }
    }
