knightspan/Nashik-Water/(commit log)

2026-11-07 Smart water quality monitoring system for Nashik: full stack
    FastAPI + PostgreSQL back end (ingest, alerts, SSE, auth, retention),
    React front end (map, site pages, alerts, admin, English/Marathi),
    simulator, retrained ML pipeline, Raspberry Pi service, firmware,
    USB serial bridge, no-Docker dev scripts, CI and deployment config.
2026-11-07 ESP32-C3 field station posting straight to the cloud; simulator runs on Render
    - firmware/esp32c3_station: Wi-Fi + HTTPS (pinned roots) to /api/ingest/batch every 10 s,
    calibration mode, sensor check, on-board decision tree, 1 h offline buffer, optional LEDs
    - start.sh runs the demo simulator next to the API (SIMULATOR_ENABLED), so no PC is needed
    - simulator re-reads the site list every 5 min and stops when a site gets a real station
    - website About/Project pages and docs describe the station architecture (docs/STATION.md)
2026-11-07 pH meter test sketch for the ESP32-C3 Super Mini (SEN0161 sample, ported)
2026-11-13 4-sensor test sketch for the ESP32-C3 (pH, TDS, turbidity, DS18B20)
